rjweld21/OpenSourcePneumaticSystem/docs/README.md

# Documentation

****NOTE: Presentation within this folder is in PDF format but includes GIF files 
which are unable to be played. If you would like to see the original presentation 
go to https://docs.google.com/presentation/d/1qn12ZttDK5l6LJ4Nng2EJIb7zYUYC_d7R4qSyoiYsHc/edit?usp=sharing

### Additional Spec Sheets
The spec sheet links listed below are for components which don't have a whole datasheet 
but rather just a short specs webpage
1. VIAIR Pressure Regulator
    - https://www.viaircorp.com/air-accessories/pressure-regulator
