rjweld21/OpenSourcePneumaticSystem/docs/Consultant I Final Presentation.pdf

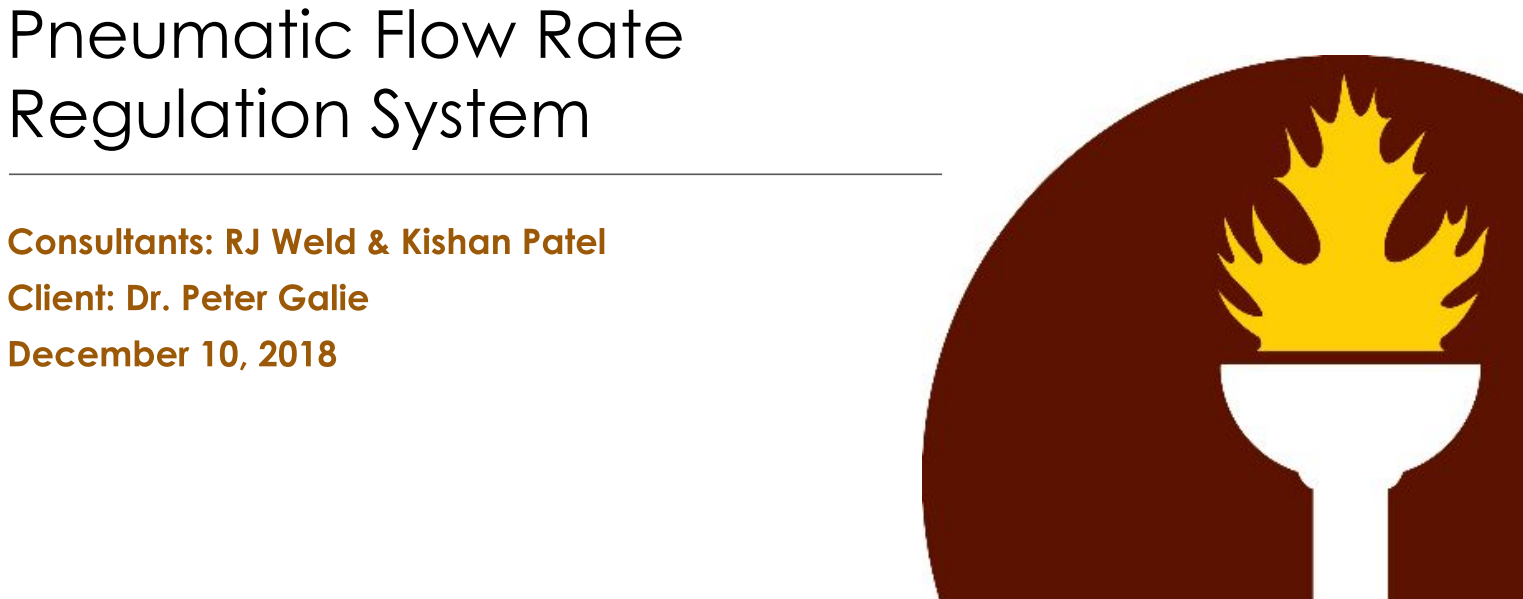
[picture p5: page 1]

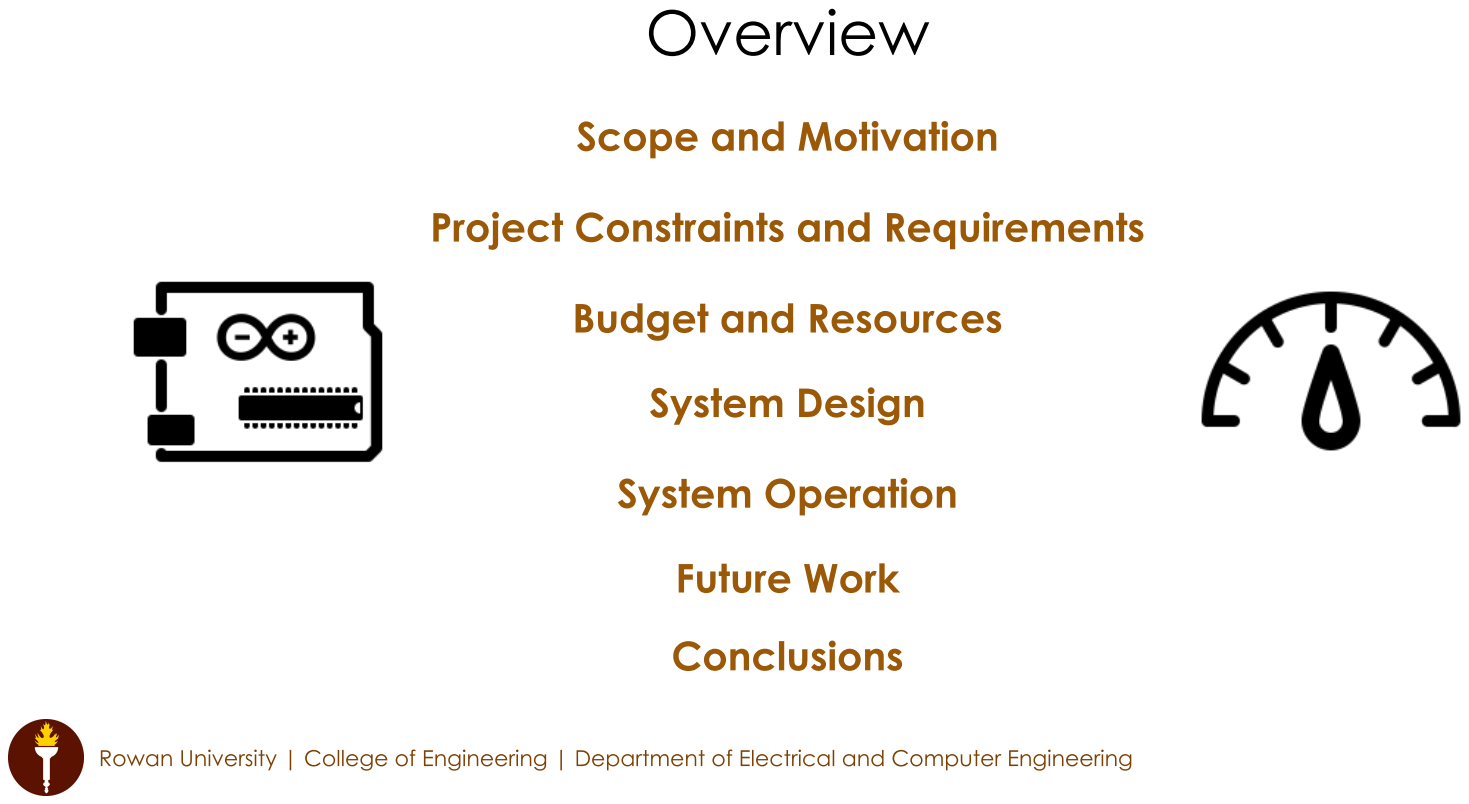
[picture p6: page 2]

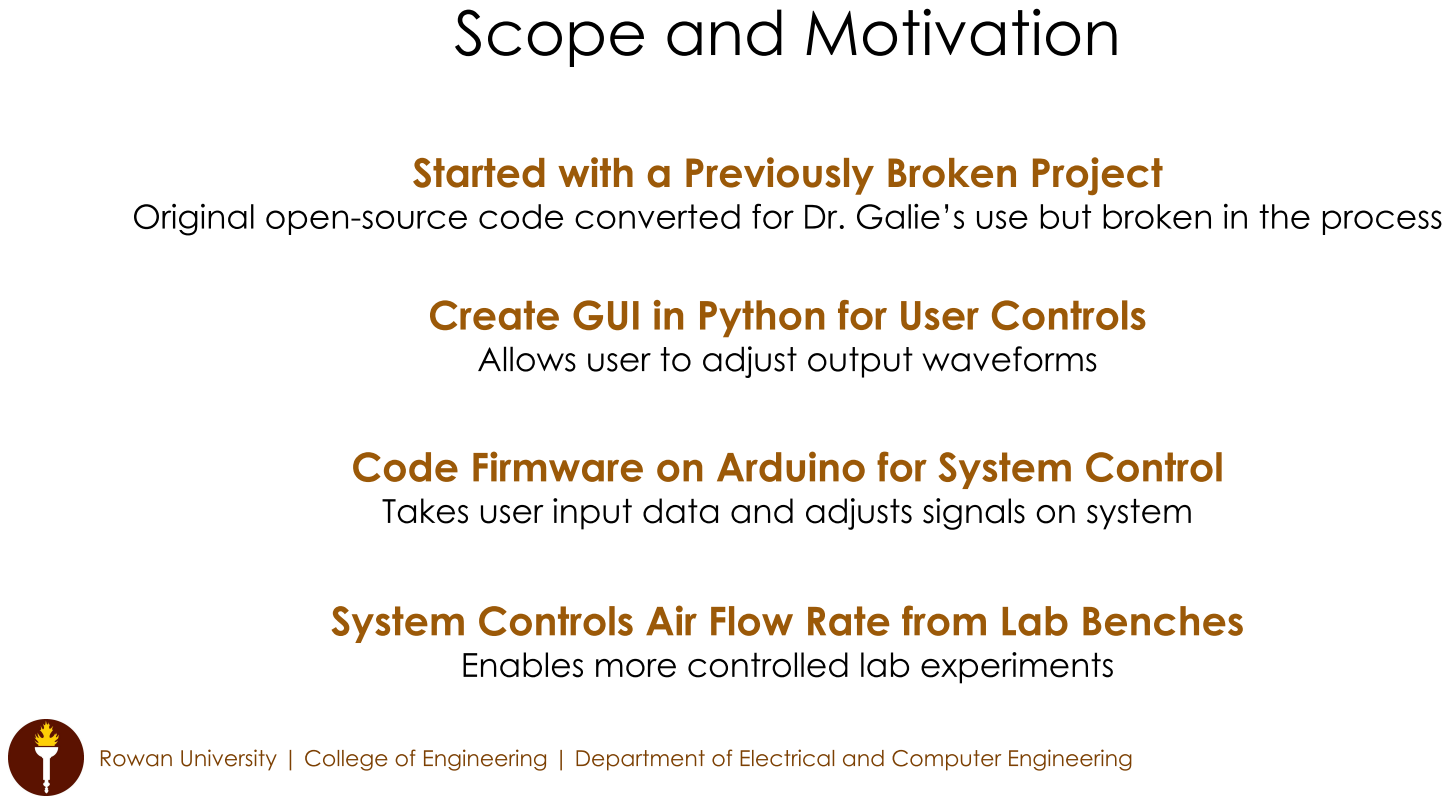
[picture p7: page 3]

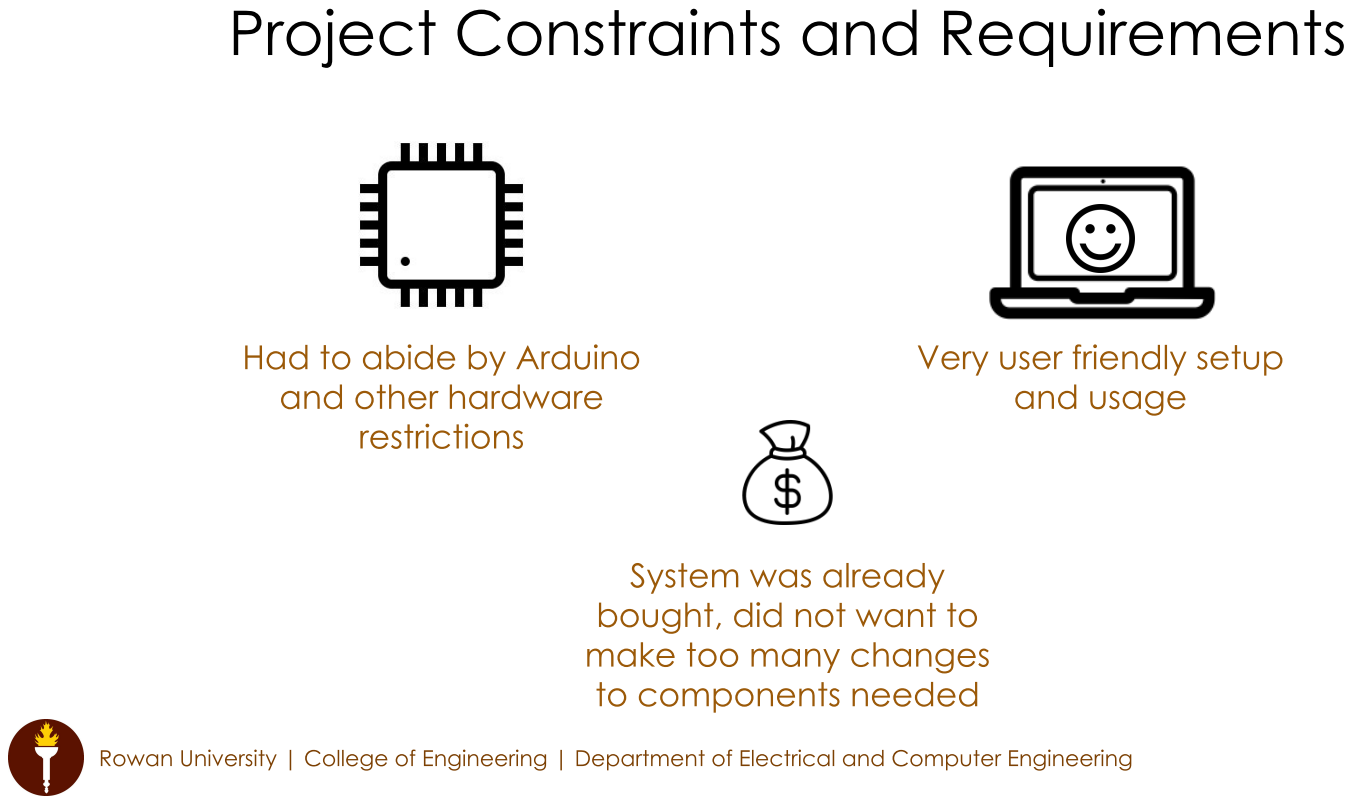
[picture p8: page 4]

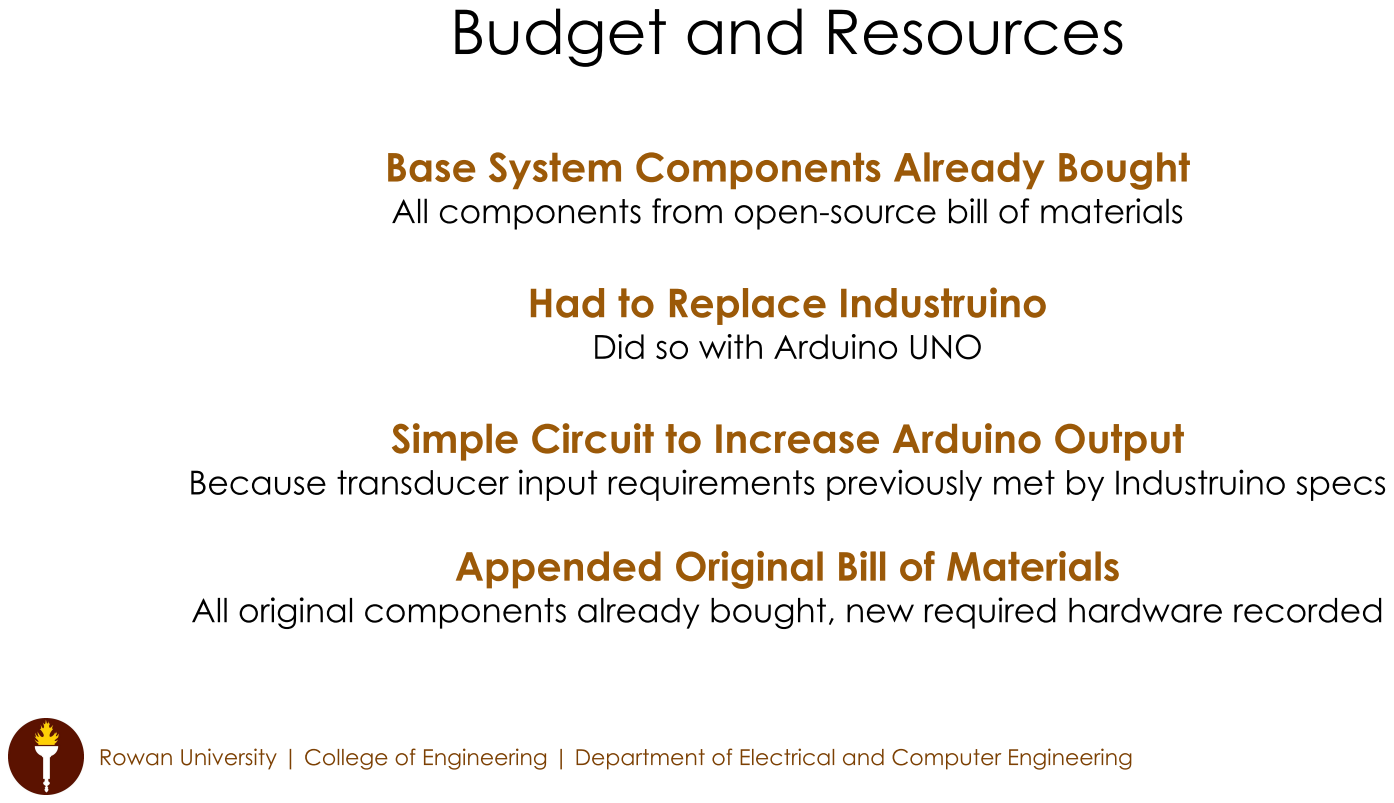
[picture p9: page 5]

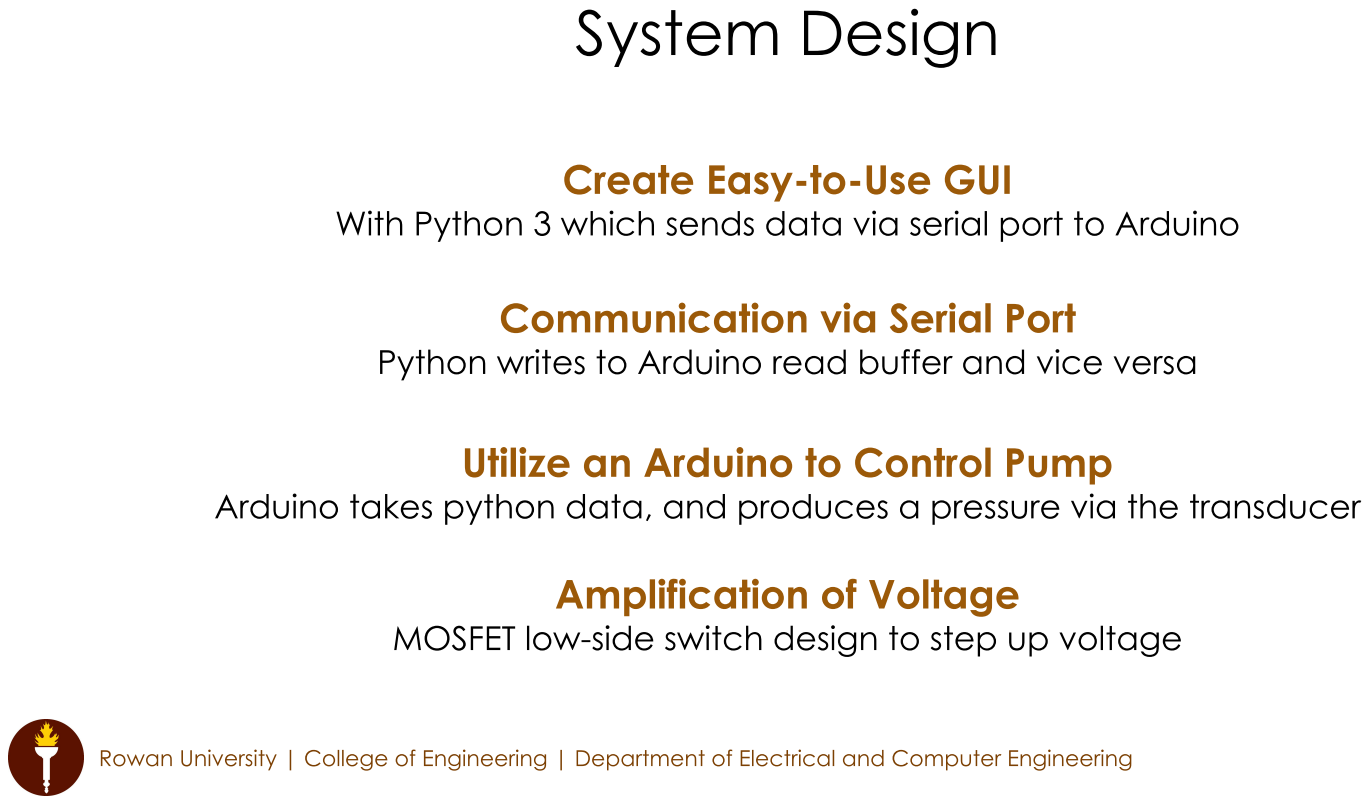
[picture p10: page 6]

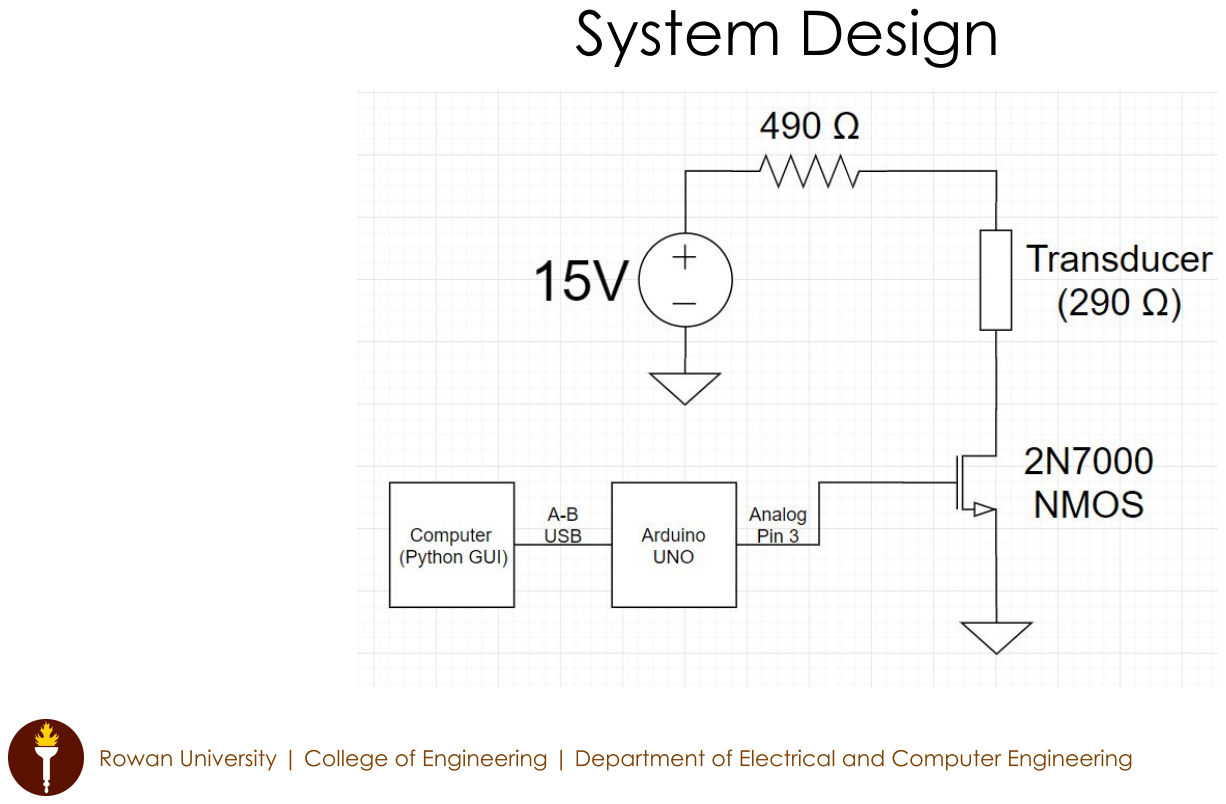
[picture p11: page 7]

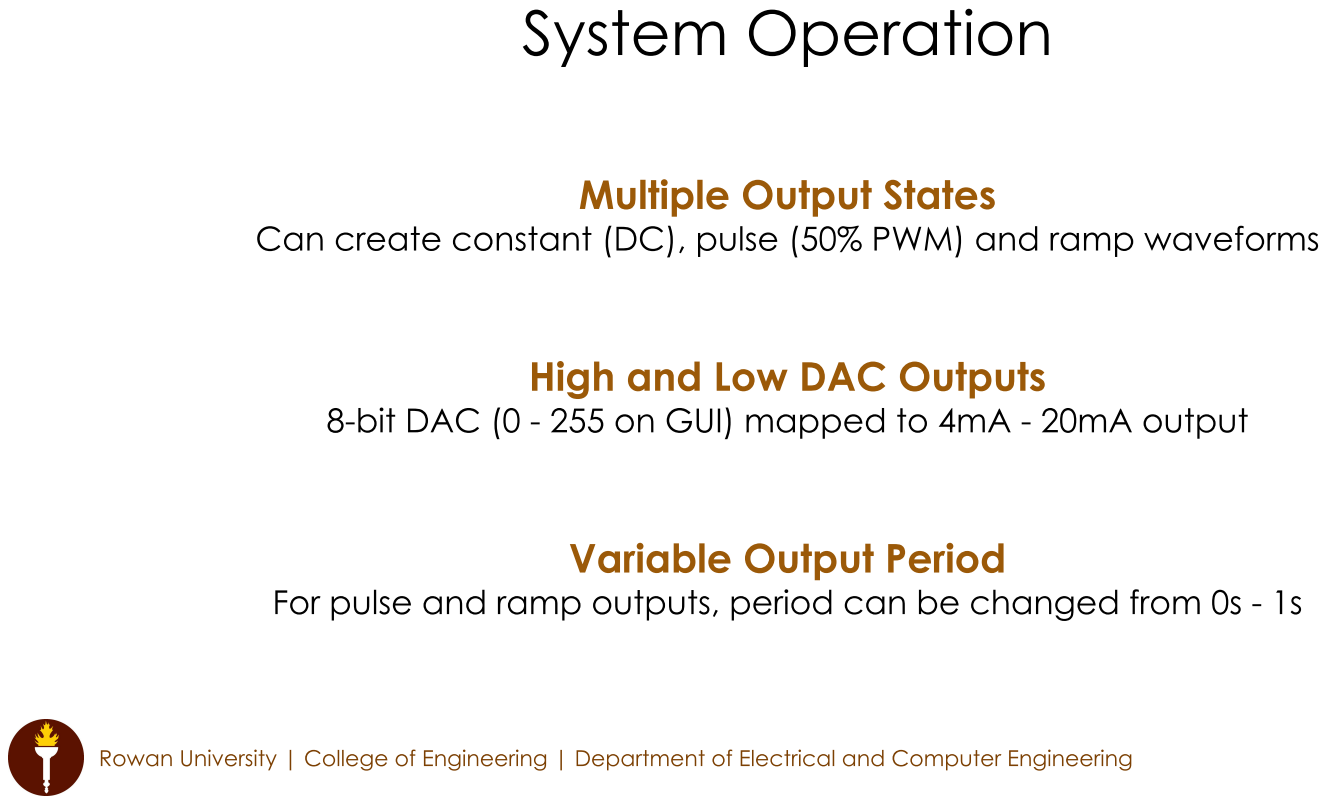
[picture p12: page 8]

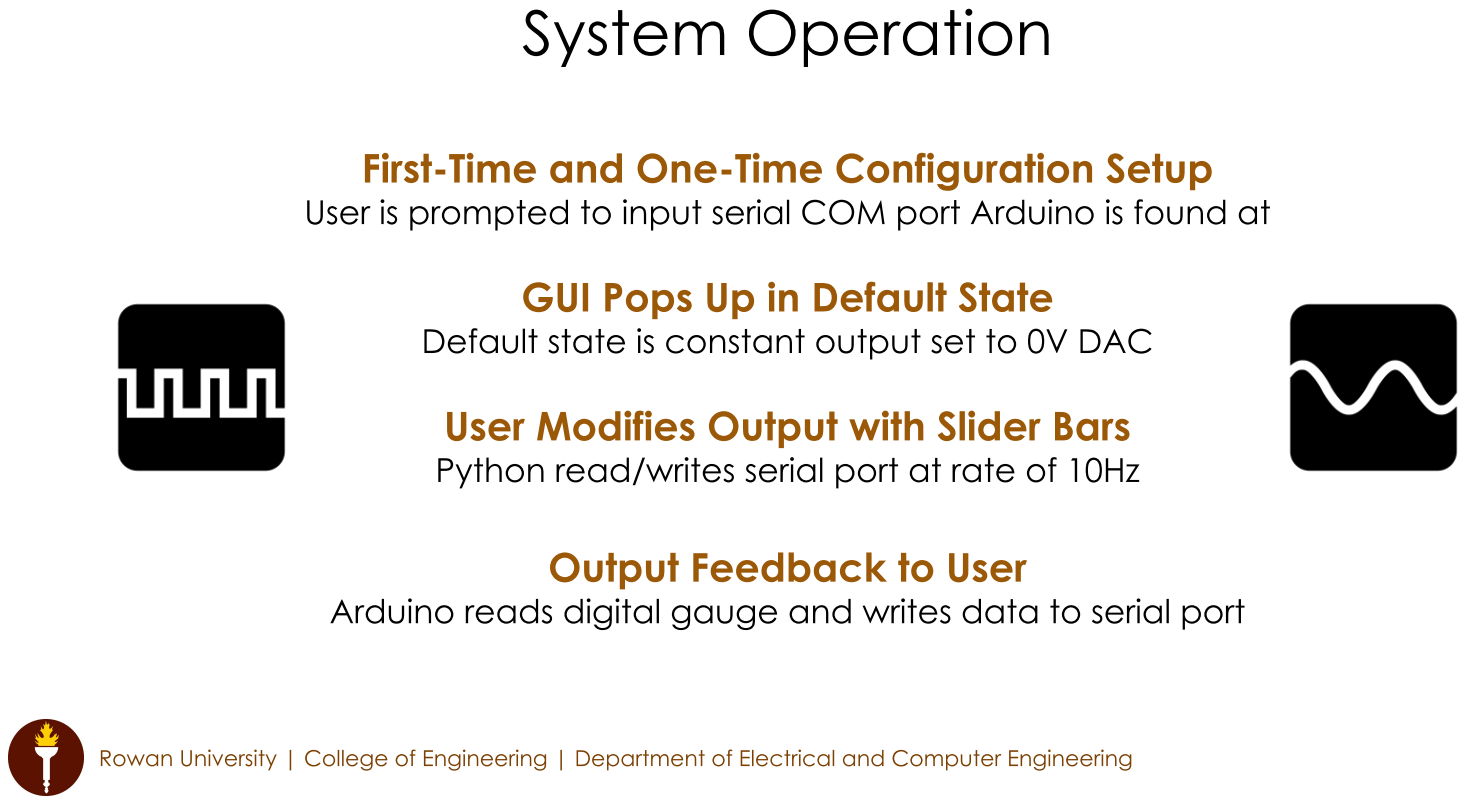
[picture p13: page 9]

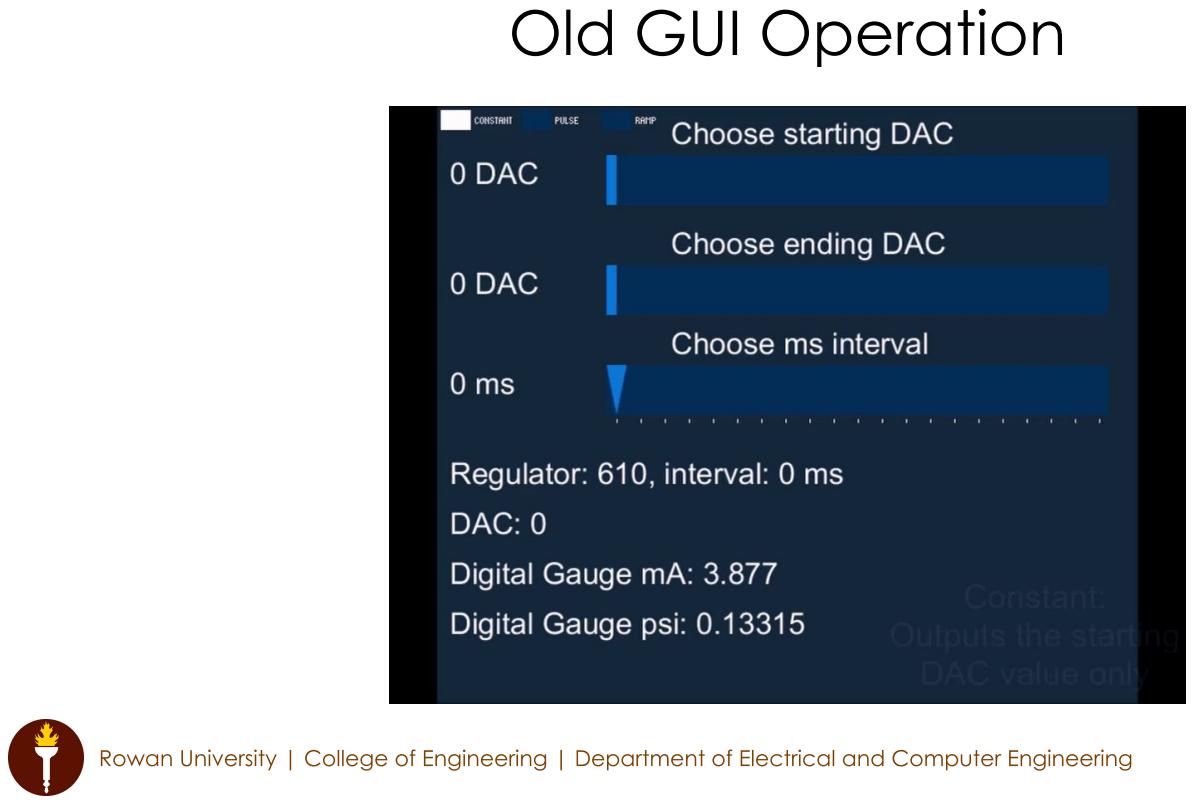
[picture p14: page 10]

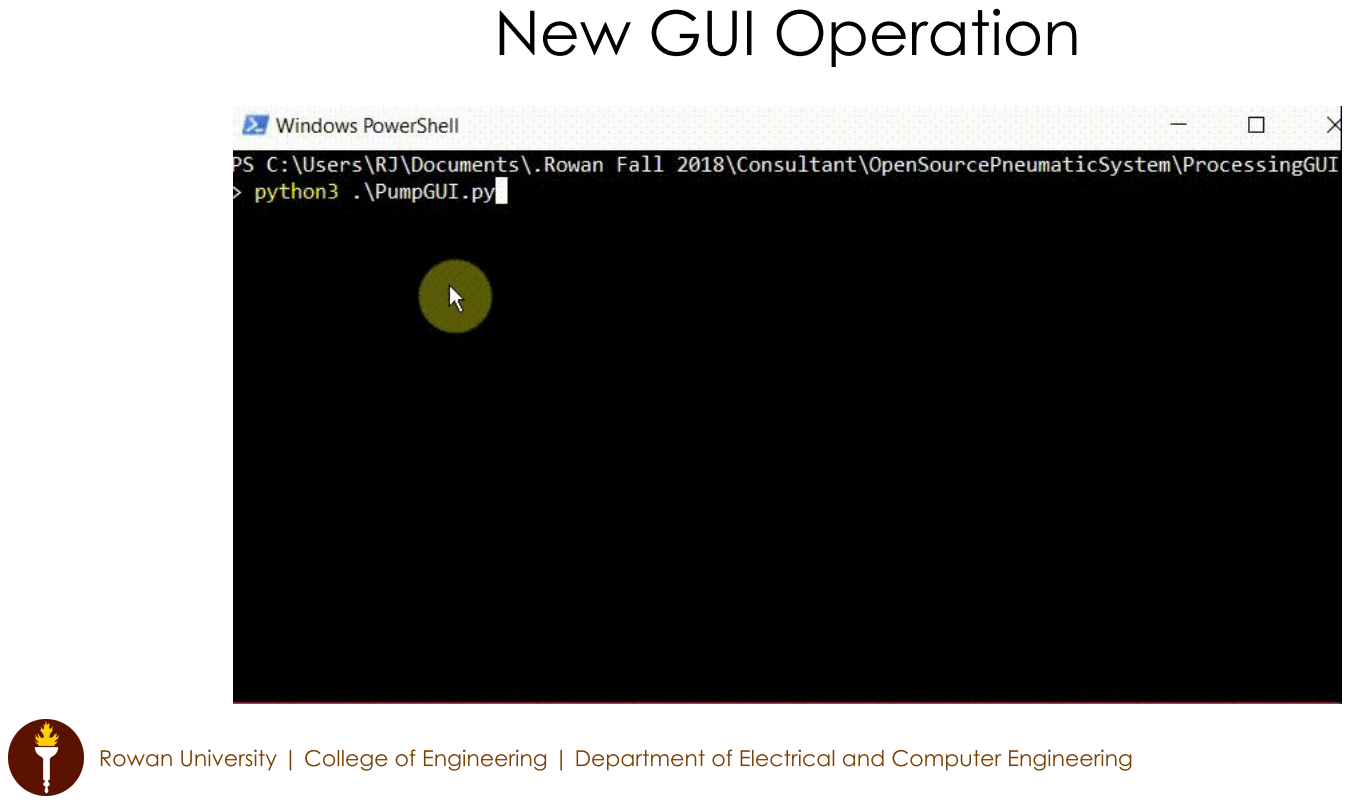
[picture p15: page 11]

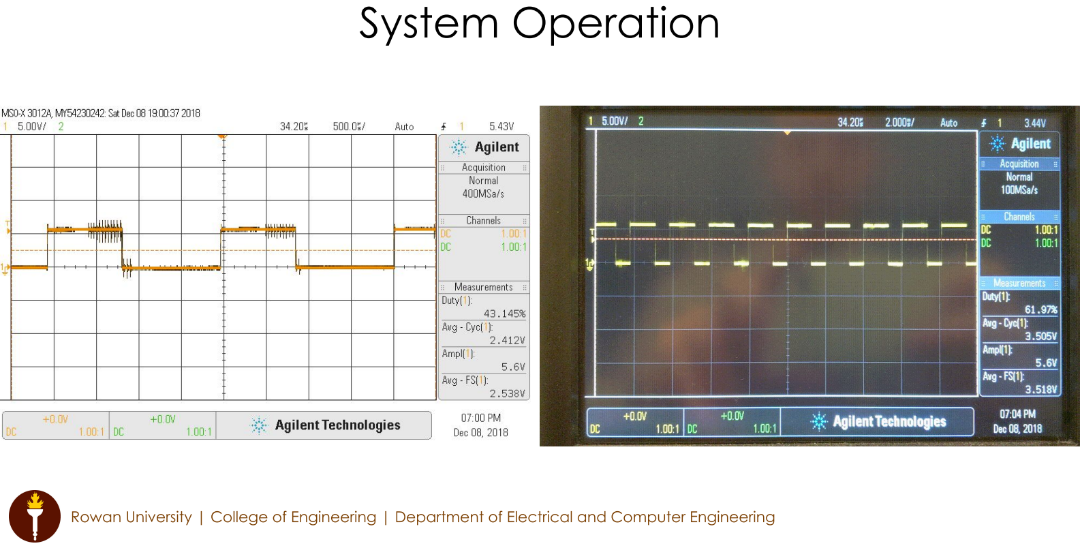
[picture p16: page 12]

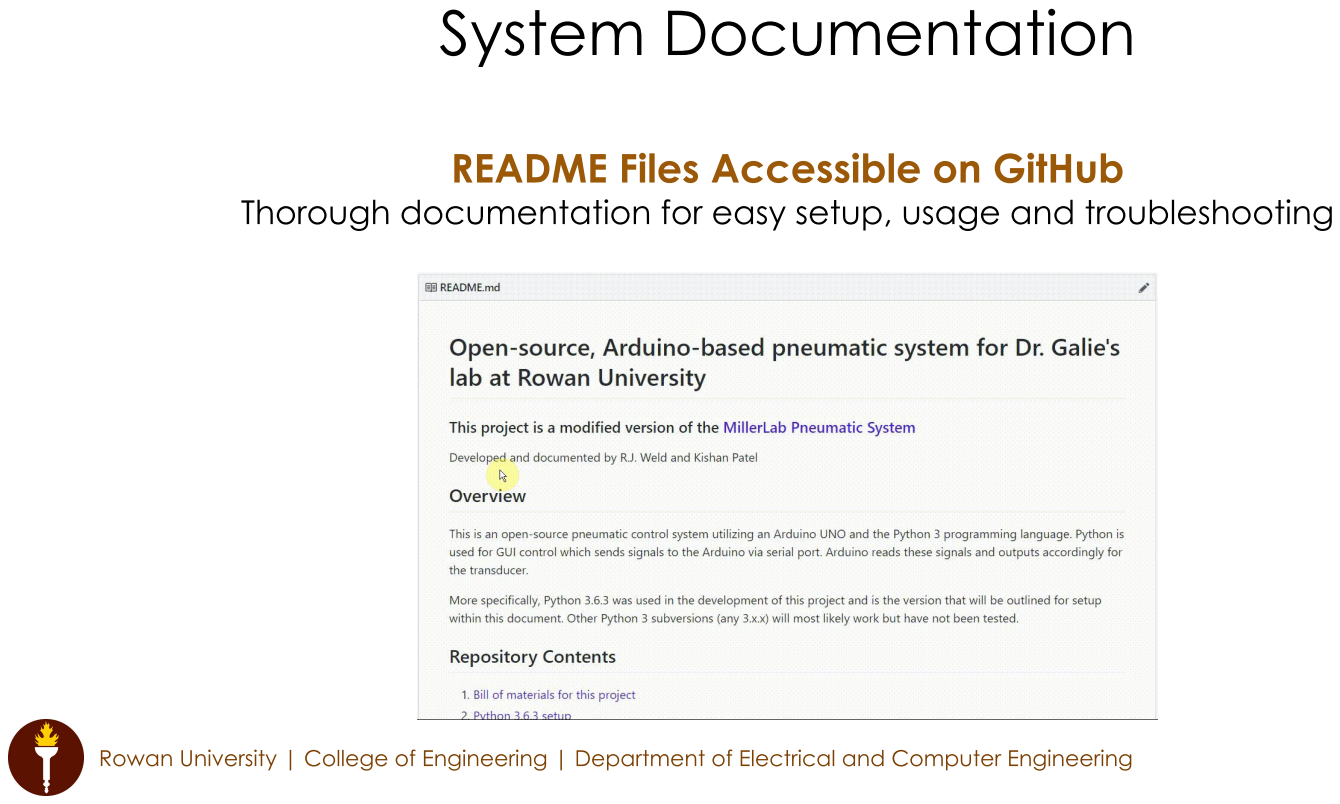
[picture p17: page 13]

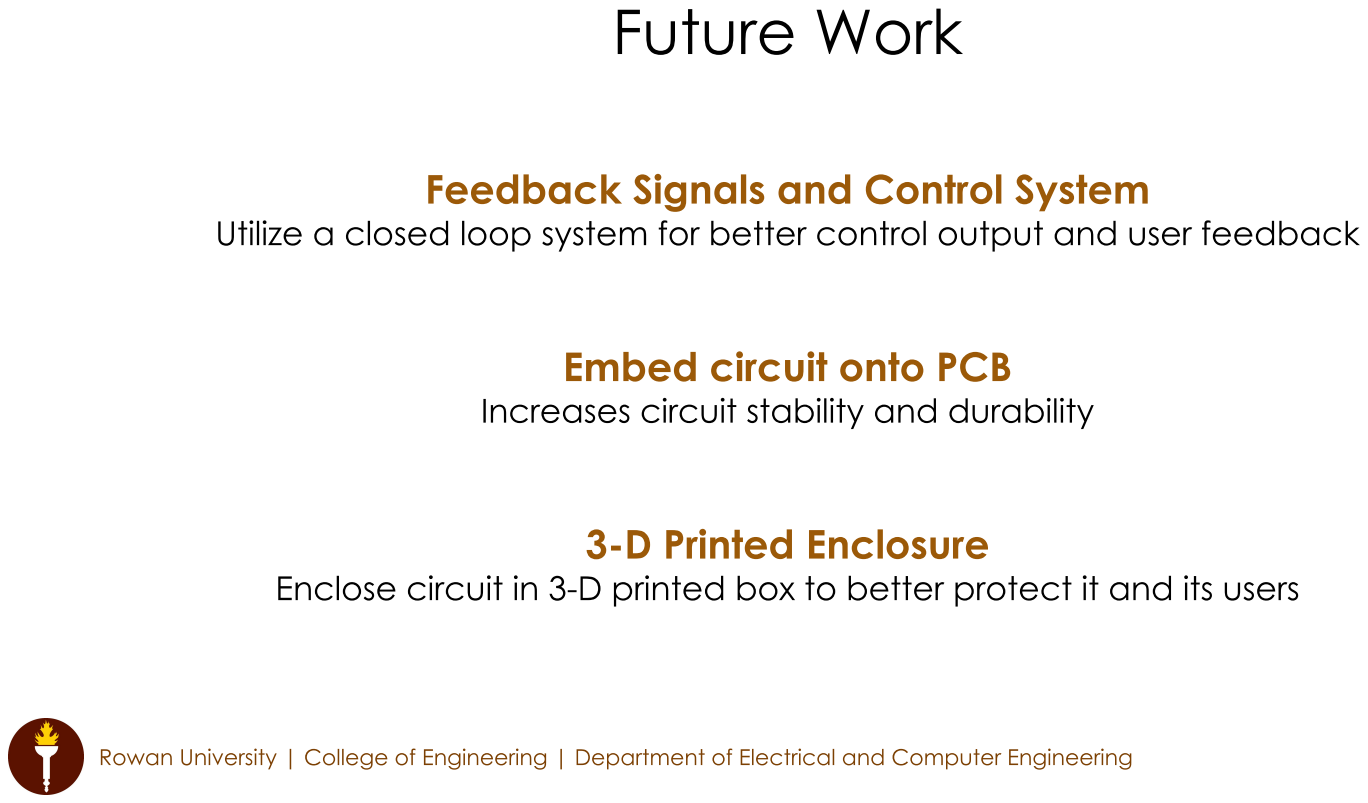
[picture p18: page 14]

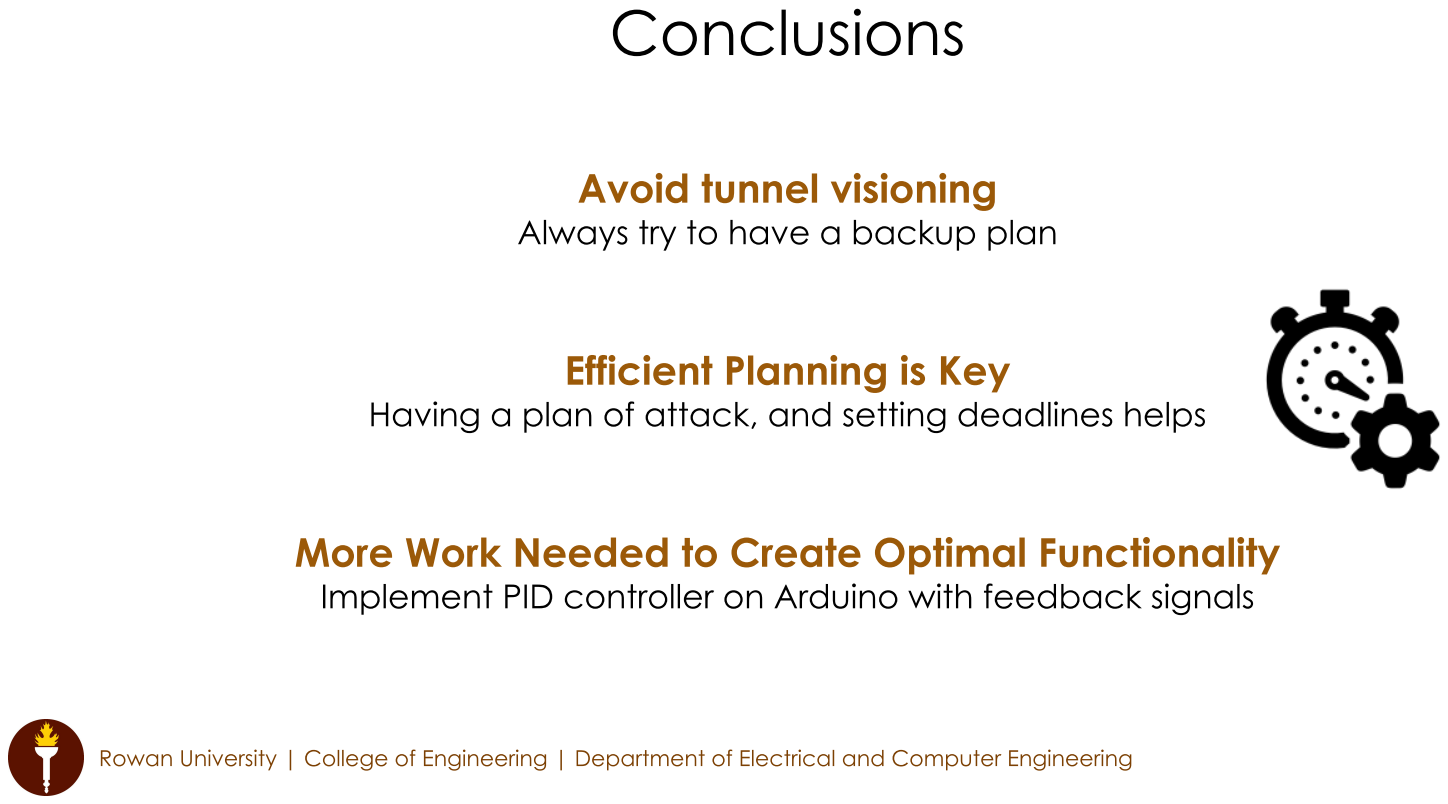
[picture p19: page 15]

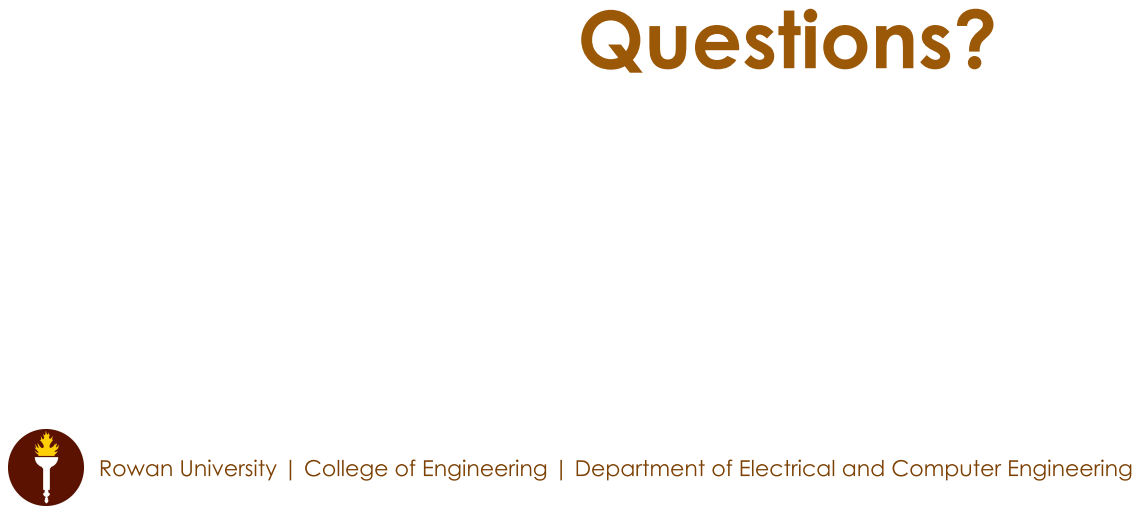
[picture p20: page 16]
