rjweld21/OpenSourcePneumaticSystem/(commit log)

2018-10-04 adding more serial comm tests between arduino and python, also created class for handling arduino serial comm
2018-10-19 renamed serial module... working to fix hanging that occurs when writing serial com
    [ArduinoSerial.py, SerialMonitor.py]
2018-11-19 update documentation
    [Pneumatic System Bill of Materials.xlsx]
2018-12-03 added config setup, updated firmware to get correct serial comm between gui and arduino, updated readme and documentation
    [ArduinoSerial.py, PumpControl.py, config.py]
2018-12-08 Finished Arduino Firmware, updated/added a lot of documentation for setup, debugging/troubleshooting and usage
    [Pneumatic System Bill of Materials.xlsx]
2018-12-13 updating documentation, removing unneeded old files, keeping some old files for reference for future teams
    [Pneumatic System Bill of Materials.xlsx]
2018-12-13 System Schematic
2018-12-13 Schematic information
